Martin5009/delay-pedal/README

A 16-bit, FPGA-based digital delay pedal implementation.
