Martin5009/delay-pedal/pcb/fabrication/delay_pedal-bom-smd.xlsx

Comment | Designator | Footprint | JLCPCB Part # | MFR Part #
X7R_0.1u_Ceramic_Capacitor | C1, C2, C3, C10, C12, C22, C23, C37, C41, C42, C43, C44, C45, C46, C47, C48, C49, C50, C52, C53, C54, C55 | 0603 | C108079 | CC0603KRX7R7BB104
C0G_9.1n_Ceramic_Capacitor | C13, C33 | 0603 | C7282234 | GRM1885C1H912JA01D
C0G_15n_Ceramic_Capacitor | C14, C34 | 0603 | C1882912 | C0603C153M3GEC7411
X7R_10n_Ceramic_Capacitor | C21 | 0603 | C161232 | GCM188R72A103KA37D
X5R_10u_Ceramic_Capacitor | C28, C29, C30, C31, C39 | 0603 | C90053 | GRM188R61A106ME69D
X5R_47u_Ceramic_Capacitor | C35, C56 | 1206 | C94034 | GRM31CR61A476ME15L
X5R_1u_Ceramic_Capacitor | C4, C11, C18, C20, C24, C27, C32, C36, C38, C51 | 0603 | C14664 | CC0603KRX5R8BB105
C0G_0.1u_Ceramic_Capacitor | C5, C60, C40 | 1206 | C363929 | GRM3195C1H104JA05D
C0G_0.47u_Ceramic_Capacitor | C58, C59 | 1206 | C6049896 | GRM31C5C1E474JE01L
C0G_160p_Ceramic_Capacitor | C6, C16 | 0603 | C327274 | CC0603JRNPO9BN161
C0G_8.2n_Ceramic_Capacitor | C7, C17 | 0603 | C162249 | GRM1885C1H822JA01D
C0G_2n_Ceramic_Capacitor | C8, C25 | 0603 | C2168932 | GRM1885C1H202JA01D
C0G_10n_Ceramic_Capacitor | C9, C15, C26 | 0603 | C85973 | GRM1885C1H103JA01D
Clipper_LED_Red | D1, D2 | 0603 | C2693608 | SML-D12U1WT86
Indicator_LED_Green_ | D3, D4 | 0603 | C9900037471 | B1911PG--20D000514U1930
Schottky_Diode | D6 | SOD-323 | C146335 | CUS10S30,H3F
1M_Resistor | R1, R2, R36, R34 | 0603 | C105578 | RC0603FR-071ML
845_Resistor | R10, R27 | 0603 | C273800 | RC0603FR-07845RL
1.82k_Resistor | R11, R28 | 0603 | C273756 | RC0603FR-071K82L
20k_Resistor | R12, R13, R14, R31, R32 | 0603 | C105575 | RC0603FR-0720KL
3.6k_Resistor | R18 | 0603 | C137729 | RC0603FR-073K6L
40k_Resistor | R21, R29, R30, R35 | 0603 | C861392 | RT0603BRD0740KL
10k_Resistor | R3, R8, R15, R16, R17, R19, R20, R33 | 0603 | C98220 | RC0603FR-0710KL
1k_Resistor | R37 | 0603 | C22548 | RC0603FR-071KL
5.23k_Resistor | R4, R23 | 0603 | C185317 | RC0603FR-075K23L
9.76k_Resistor | R5, R24 | 0603 | C137665 | RC0603FR-079K76L
1.47k_Resistor | R6, R25 | 0603 | C482634 | RC0603FR-071K47L
3.32k_Resistor | R7, R26 | 0603 | C137731 | RC0603FR-073K32L
100_Resistor | R9, R22 | 0603 | C2074203 | RCA0603100RFKEAHP
FPGA | U1 | 84-VFQFN_7x7mm | C6639984 | ICE40LP1K-QN84
1.2V_Voltage_Regulator | U10 | SOT-23-5 | C5155199 | TPL810ADJ-5TR
5V_Voltage_Regulator | U11 | SOT-89-3 | C2842393 | TPL810F50-89TR
16_bit_ADC | U12 | VSSOP-10_3x3mm_P0.5mm | C2669921 | ADS8339IDGSR
3.3V_Voltage_Regulator | U13 | SOT-23-3 | C2683368 | TLV76033DBZR
16_bit_DAC | U15 | VSSOP-8_3x3mm_P0.65mm | C524800 | DAC8551IADGKR
4.5V_Reference | U16 | SOIC-8_3.9x4.9mm_P1.27mm | C181339 | REF5045AIDR
SPI_PSRAM | U2 | SOP-8_3.9x4.9mm_P1.27mm | C18214056 | APS1604M-3SQR-SN
Op-amp | U3, U5, U8, U9, U14, U17 | SOIC-8_3.9x4.9mm_P1.27mm | C80100 | RC4580IDR
Level_Translator | U4 | TSSOP-14_4.4x5mm_P0.65mm | C551620 | NXB0104PW-Q100J
SPI_Flash | U6 | SOIC-8_3.9x4.9mm_P1.27mm | C19617 | W25X40CLSNIG
80MHz_Crystal_Oscillator | X1 | 4-VDFN_3.2x2.5mm |  | 12.95102
