Martin5009/delay-pedal/pcb/delay_pedal.pdf

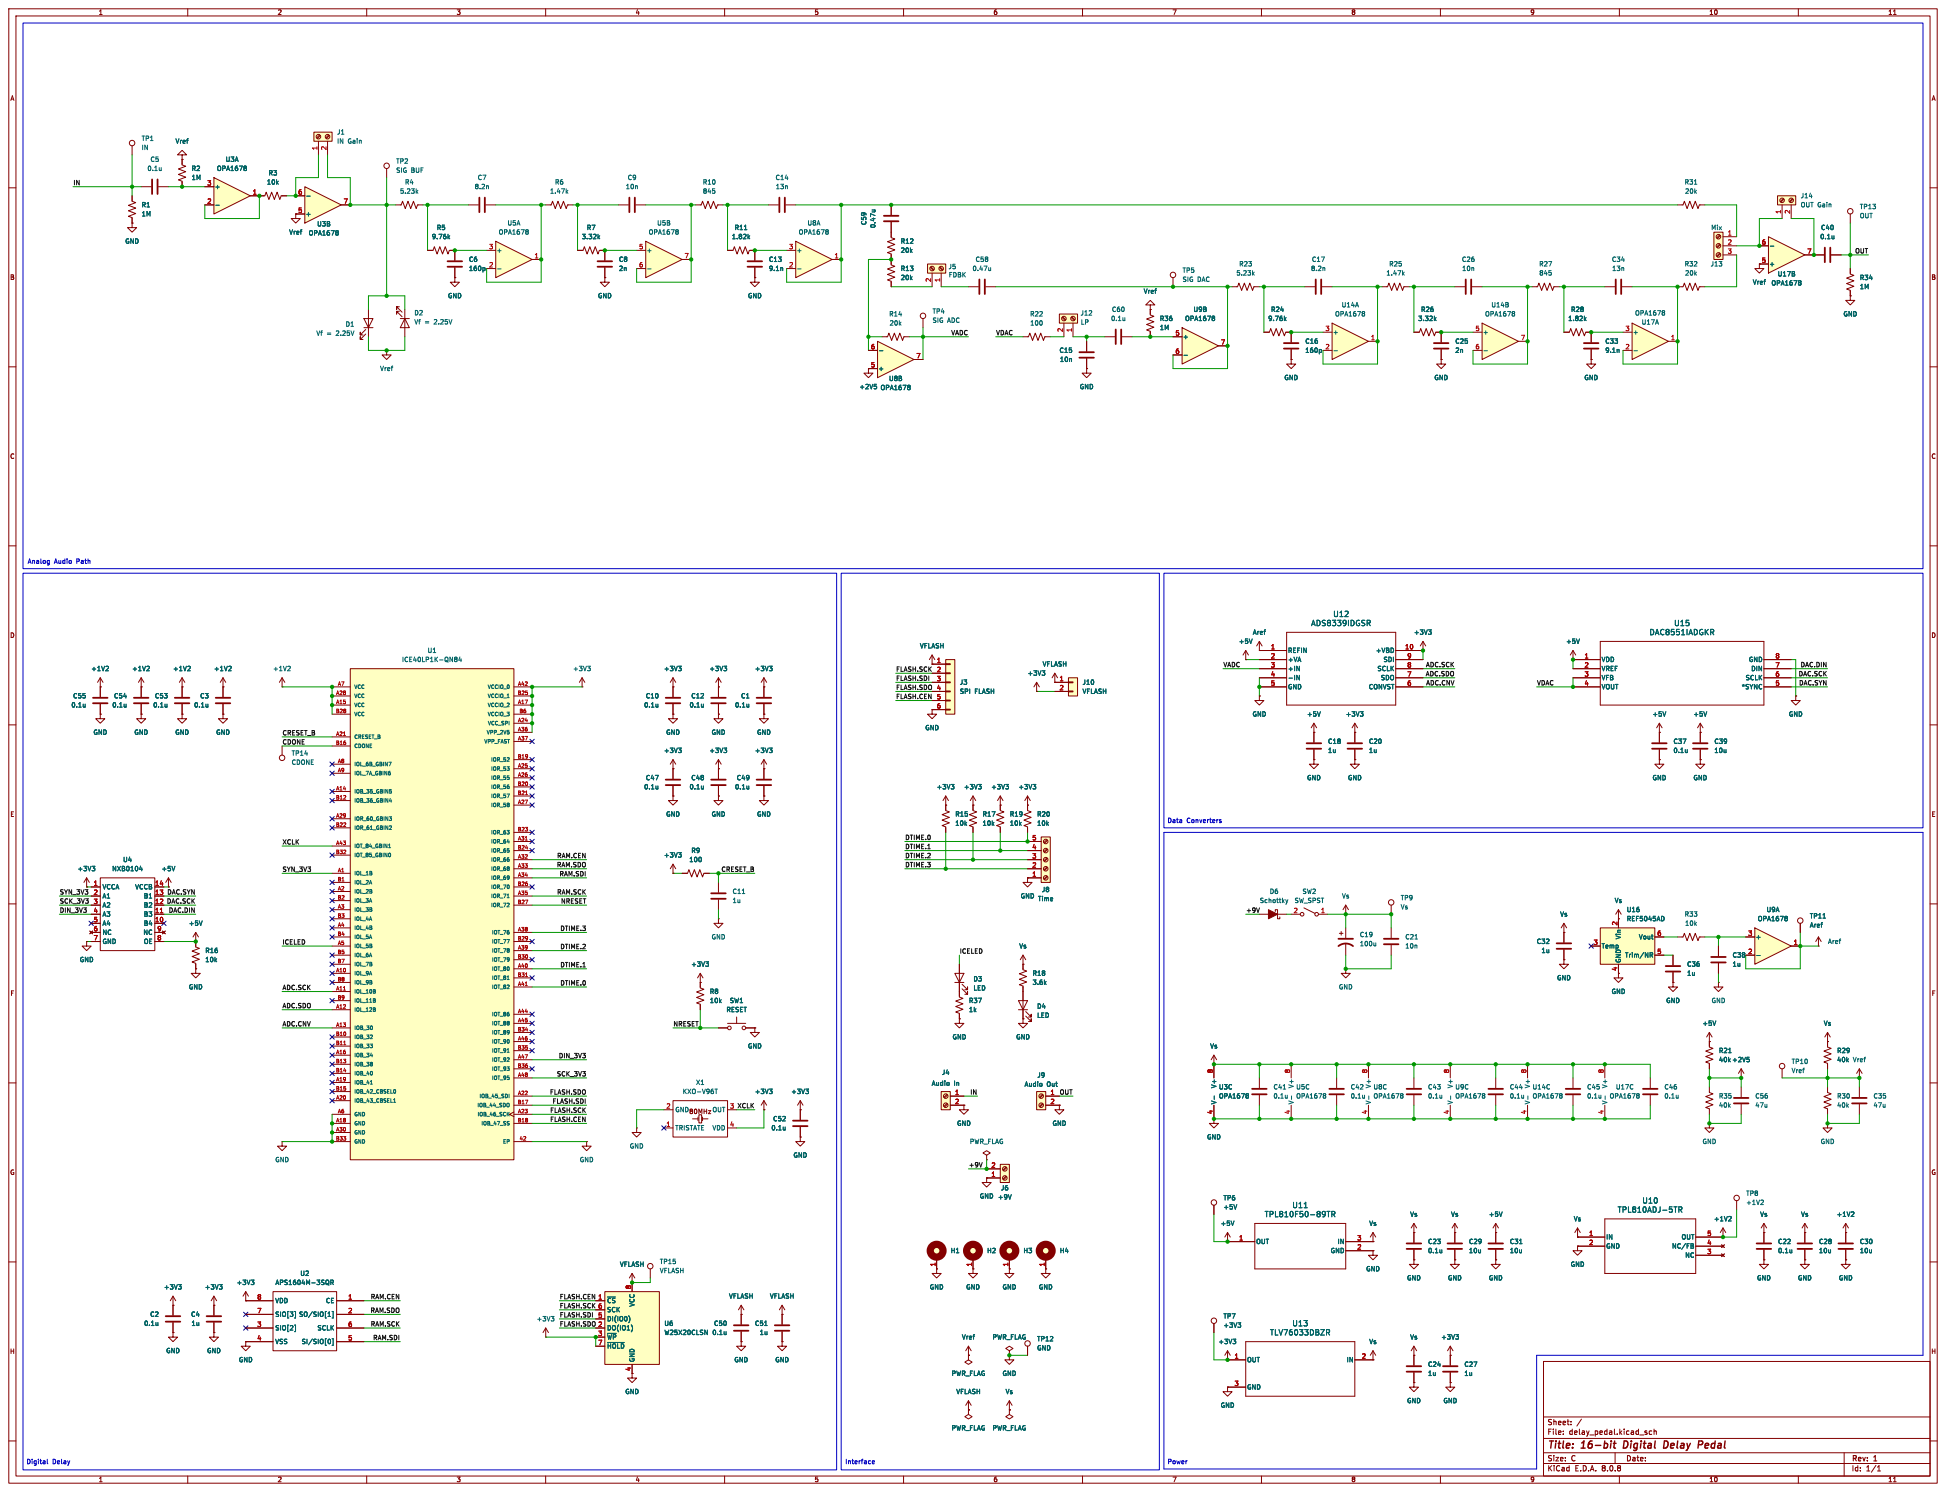
[picture p1: page 1]

FLASH.SCK
DTIME.3 FLASH.SDI FLASH.CEN
FLASH.SDO

FLASH.SDI FLASH.CEN

FLASH.CEN
FLASH.SDI FLASH.SDO

4 DI(IO0) 5 SCK 6 ~{HOLD} 7 VCC
