Martin5009/delay-pedal/pcb/delay_pedal.kicad_pcb

## KiCad design pcb/delay_pedal.kicad_pcb (2025-01-30)

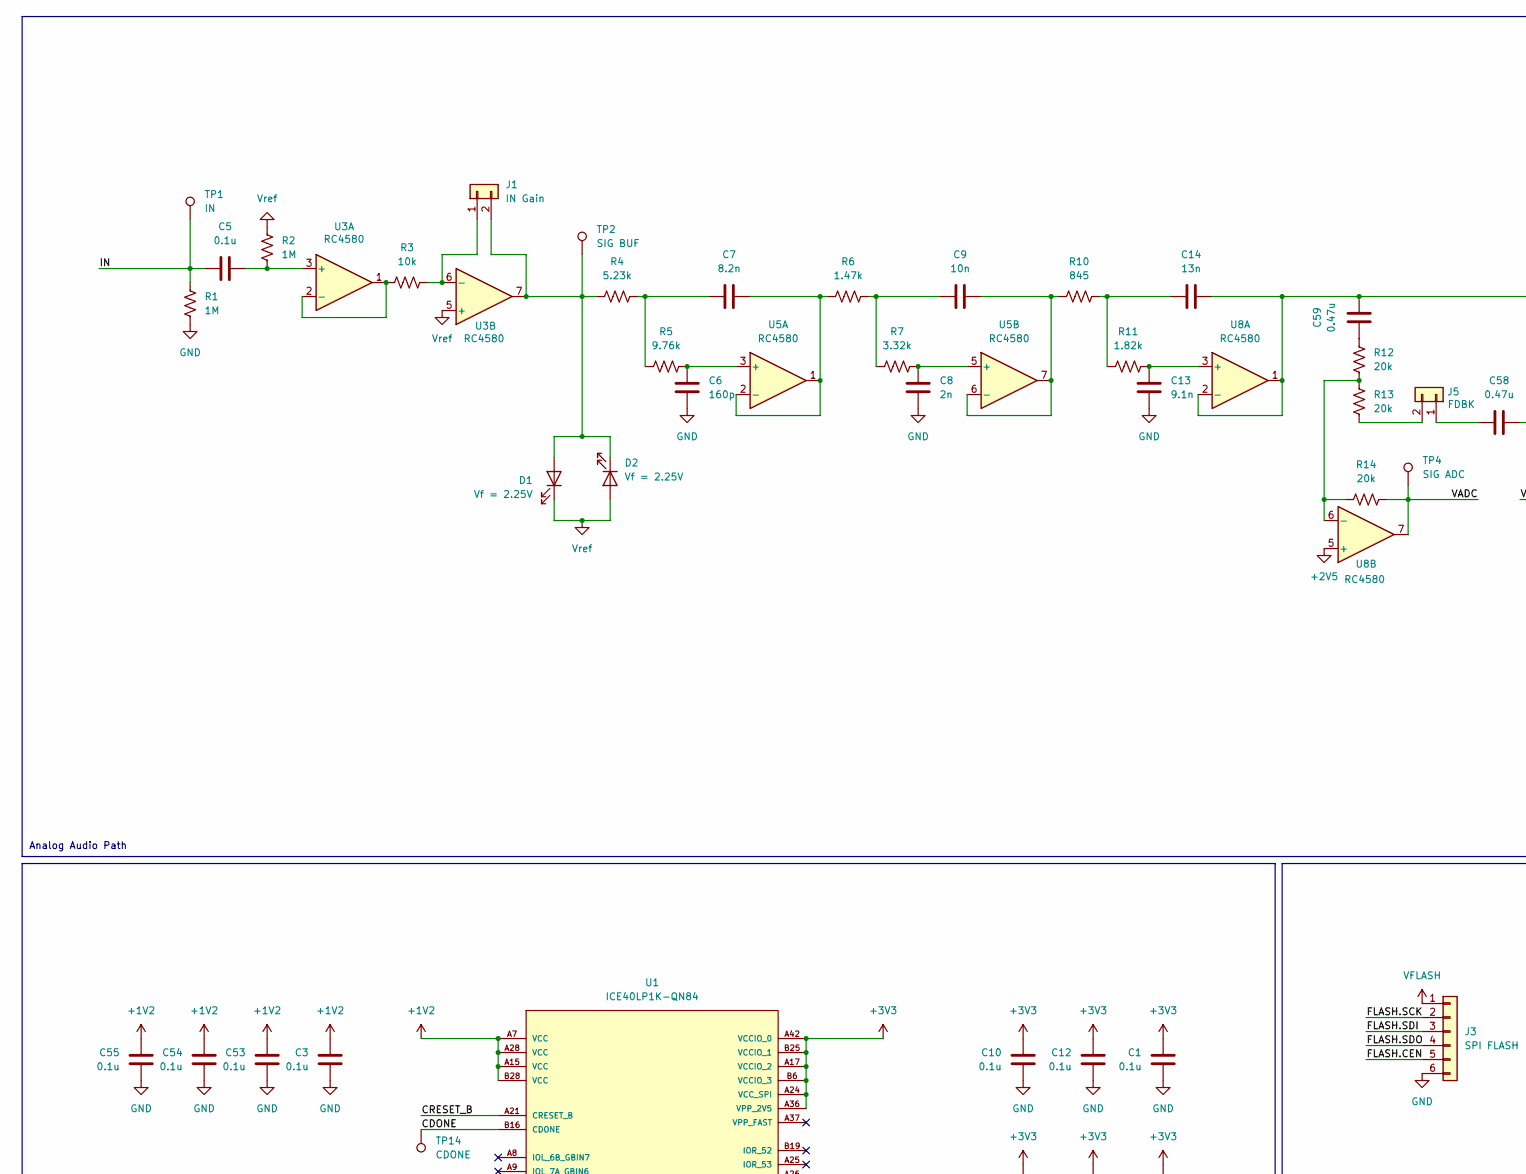
[picture p2: schematic delay_pedal.kicad_sch, 16-bit Digital Delay Pedal, part in row 1, column 1]

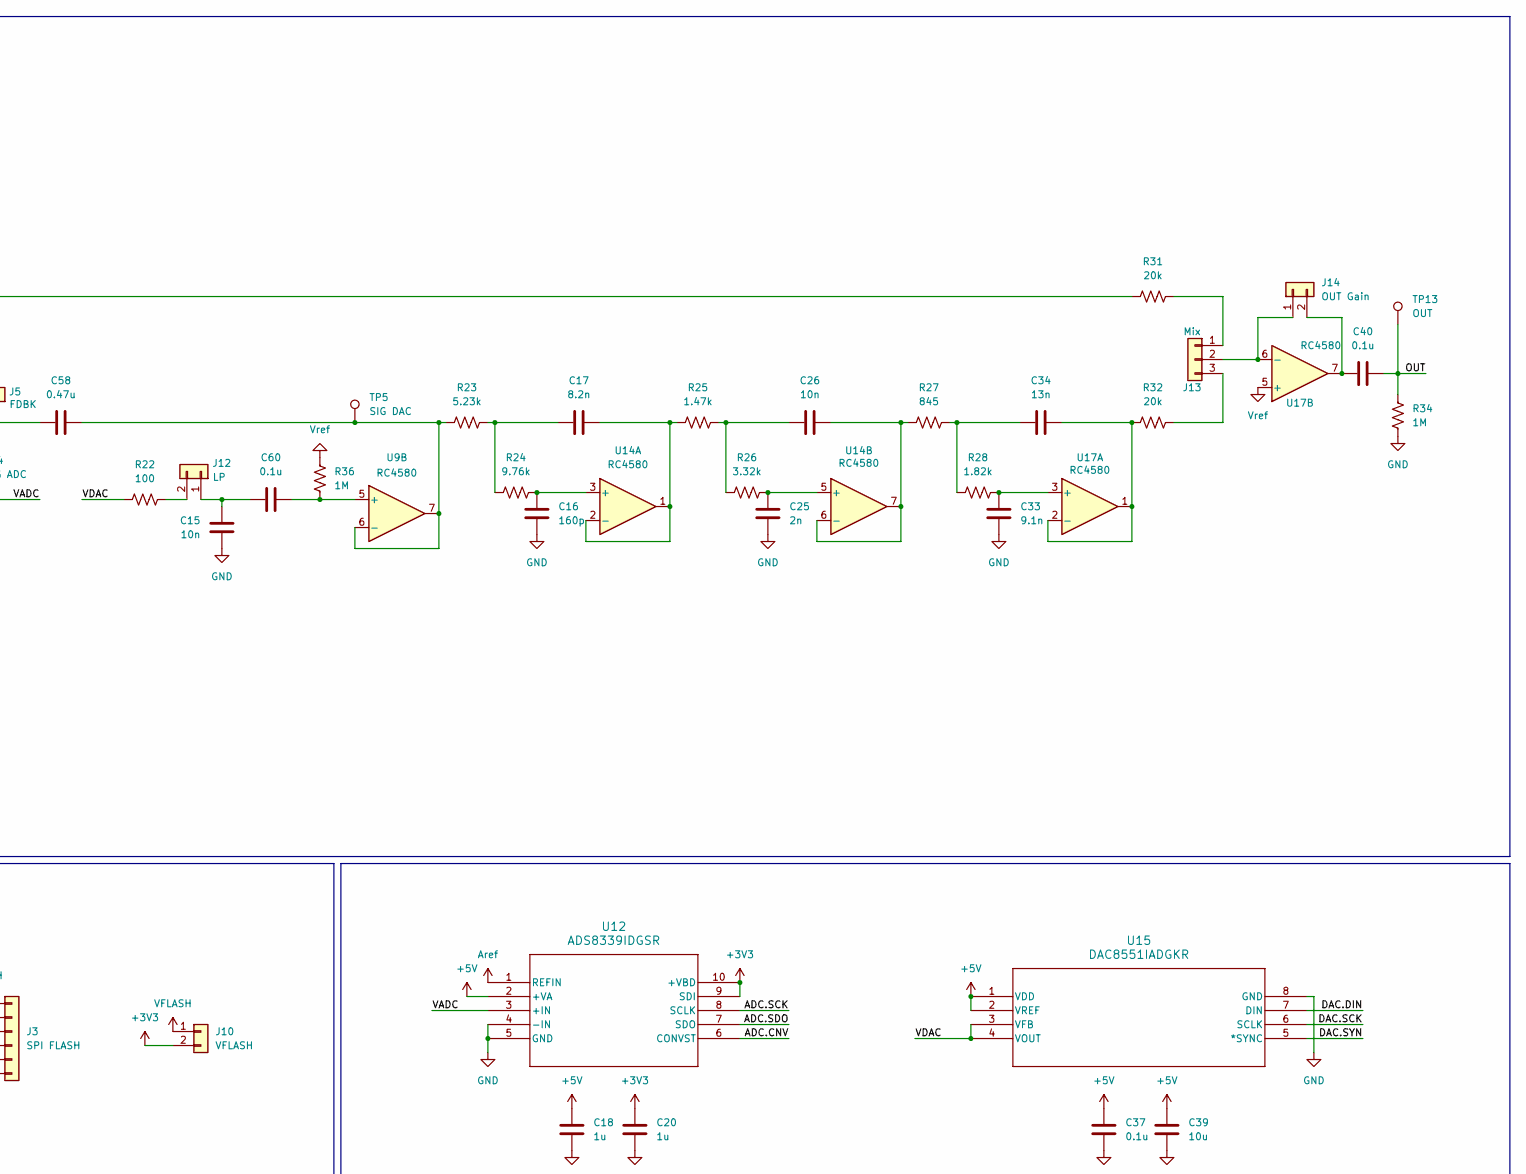
[picture p3: schematic delay_pedal.kicad_sch, 16-bit Digital Delay Pedal, part in row 1, column 2]

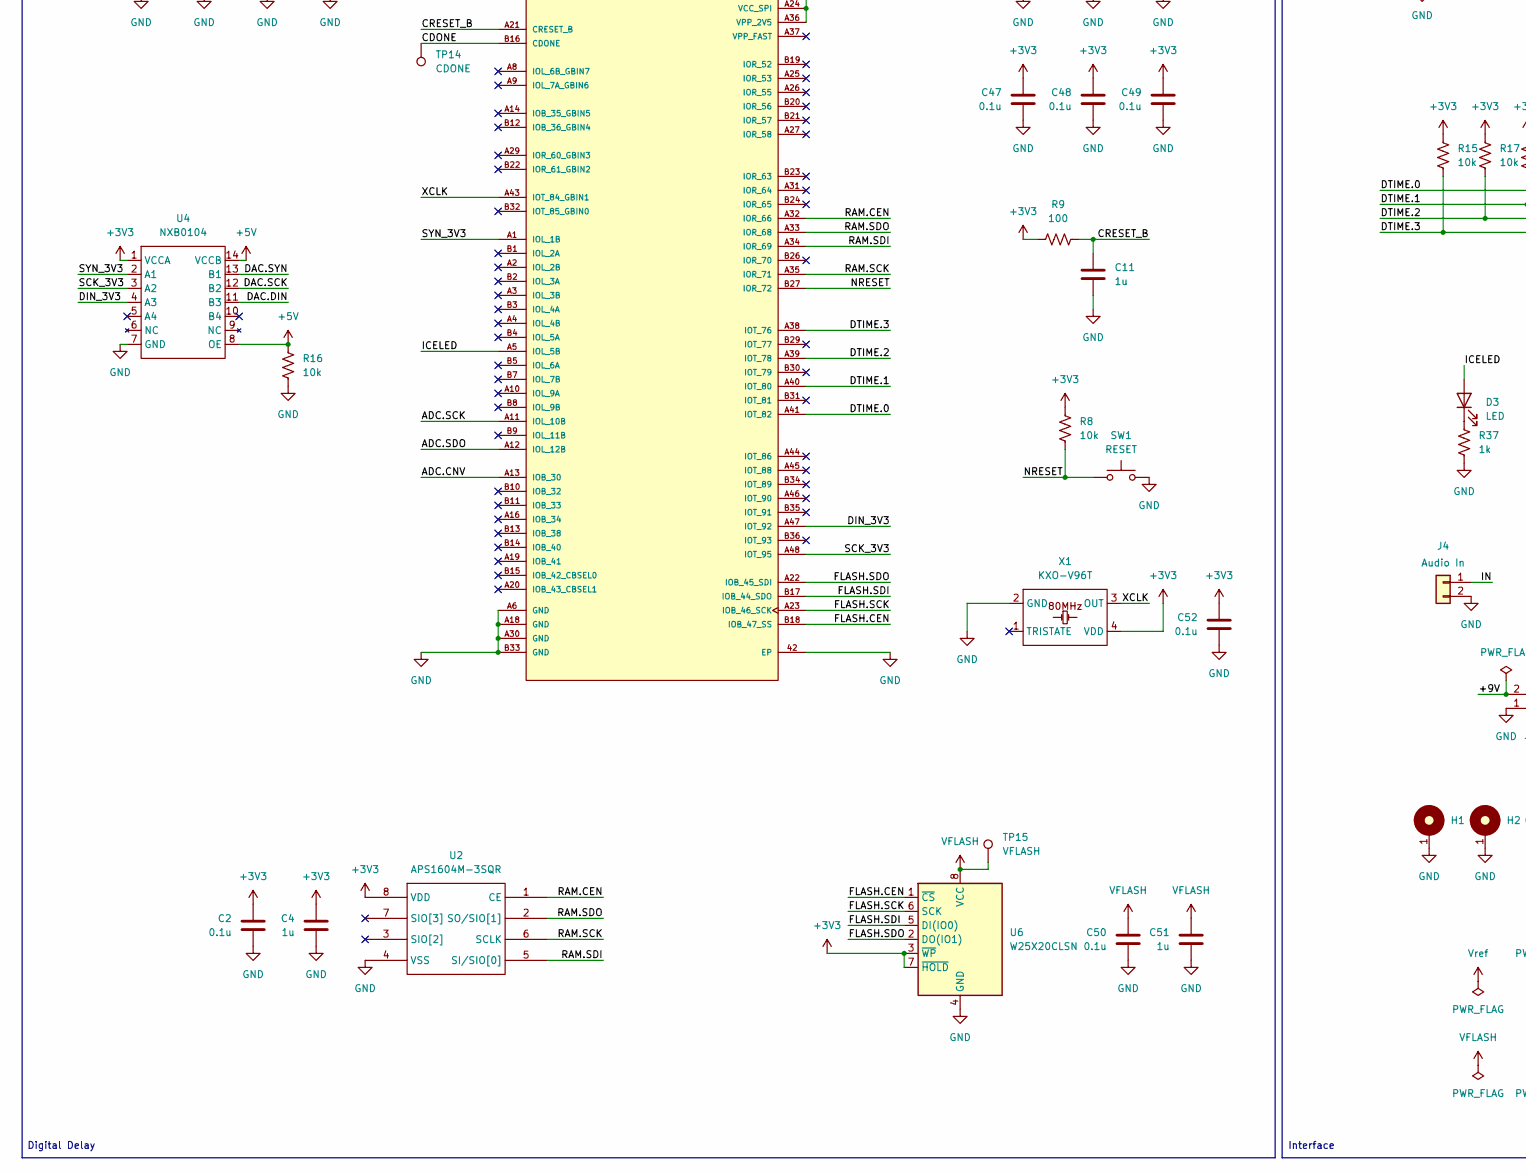
[picture p4: schematic delay_pedal.kicad_sch, 16-bit Digital Delay Pedal, part in row 2, column 1]

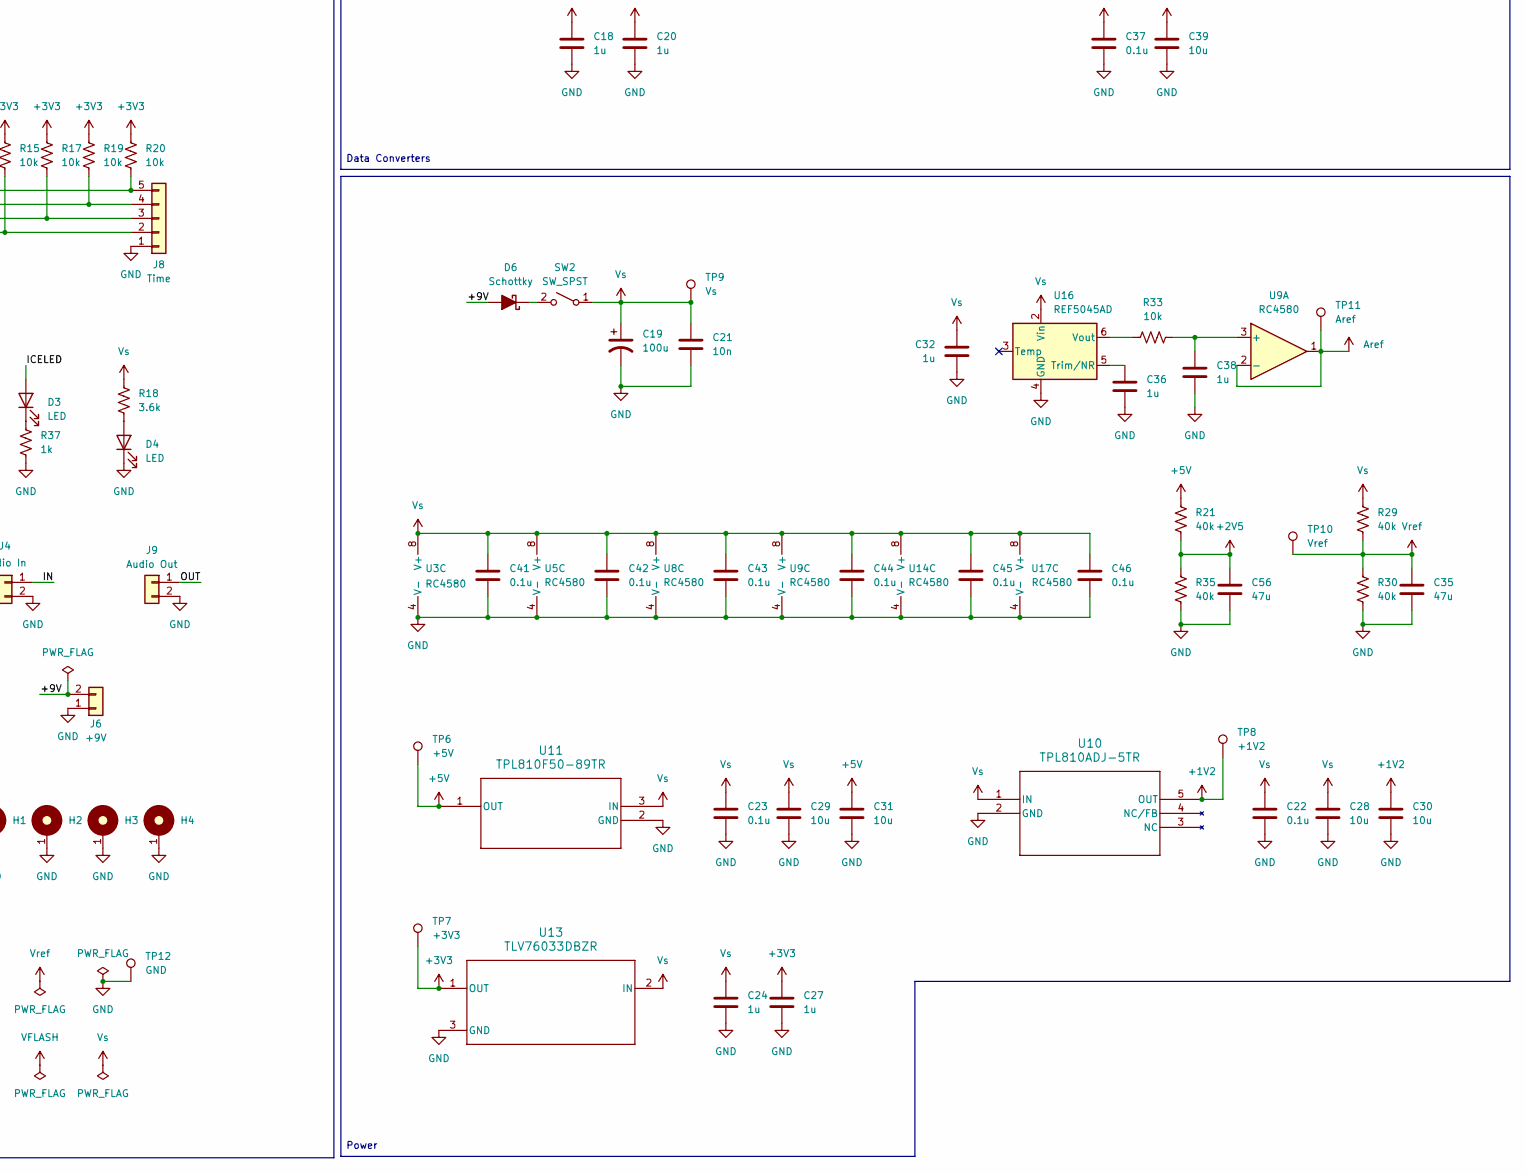
[picture p5: schematic delay_pedal.kicad_sch, 16-bit Digital Delay Pedal, part in row 2, column 2]

Parts:
C1, C2, C3, C10, C12, C22, C23, C37, C41, C42, C43, C44, C45, C46, C47, C48, C49, C50, C52, C53, C54, C55: 0.1u; C_0603_1608Metric_Pad1.08x0.95mm_HandSolder
C4, C11, C18, C20, C24, C27, C32, C36, C38, C51: 1u; C_0603_1608Metric_Pad1.08x0.95mm_HandSolder
C5, C40, C60: 0.1u; C_1206_3216Metric_Pad1.33x1.80mm_HandSolder
C6, C16: 160p; C_0603_1608Metric_Pad1.08x0.95mm_HandSolder
C7, C17: 8.2n; C_0603_1608Metric_Pad1.08x0.95mm_HandSolder
C8, C25: 2n; C_0603_1608Metric_Pad1.08x0.95mm_HandSolder
C9, C15, C21, C26: 10n; C_0603_1608Metric_Pad1.08x0.95mm_HandSolder
C13, C33: 9.1n; C_0603_1608Metric_Pad1.08x0.95mm_HandSolder
C14, C34: 13n; C_0603_1608Metric_Pad1.08x0.95mm_HandSolder
C19: 100u; CP_Radial_D6.3mm_P2.50mm
C28, C29, C30, C31, C39: 10u; C_0603_1608Metric_Pad1.08x0.95mm_HandSolder
C35, C56: 47u; C_1206_3216Metric_Pad1.33x1.80mm_HandSolder
C58, C59: 0.47u; C_1206_3216Metric_Pad1.33x1.80mm_HandSolder
D1, D2: Vf = 2.25V; LED_0603_1608Metric_Pad1.05x0.95mm_HandSolder
D3, D4: LED; LED_0603_1608Metric_Pad1.05x0.95mm_HandSolder
D6: Schottky; D_SOD-323_HandSoldering
H1, H2, H3, H4: MountingHole_M3_3.2mm_Pad; MountingHole_3.2mm_Pad
J1: IN Gain; PinHeader_1x02_P2.54mm_Vertical
J3: SPI FLASH; PinHeader_1x06_P2.54mm_Vertical
J4: Audio In; PinHeader_1x02_P2.54mm_Vertical
J5: FDBK; PinHeader_1x02_P2.54mm_Vertical
J6: +9V; PinHeader_1x02_P2.54mm_Vertical
J8: Time; PinHeader_1x05_P2.54mm_Vertical
J9: Audio Out; PinHeader_1x02_P2.54mm_Vertical
J10: VFLASH; PinHeader_1x02_P2.54mm_Vertical
J12: LP; PinHeader_1x02_P2.54mm_Vertical
J13: Mix; PinHeader_1x03_P2.54mm_Vertical
J14: OUT Gain; PinHeader_1x02_P2.54mm_Vertical
R1, R2, R34, R36: 1M; R_0603_1608Metric_Pad0.98x0.95mm_HandSolder
R3, R8, R15, R16, R17, R19, R20, R33: 10k; R_0603_1608Metric_Pad0.98x0.95mm_HandSolder
R4, R23: 5.23k; R_0603_1608Metric_Pad0.98x0.95mm_HandSolder
R5, R24: 9.76k; R_0603_1608Metric_Pad0.98x0.95mm_HandSolder
R6, R25: 1.47k; R_0603_1608Metric_Pad0.98x0.95mm_HandSolder
R7, R26: 3.32k; R_0603_1608Metric_Pad0.98x0.95mm_HandSolder
R9, R22: 100; R_0603_1608Metric_Pad0.98x0.95mm_HandSolder
R10, R27: 845; R_0603_1608Metric_Pad0.98x0.95mm_HandSolder
R11, R28: 1.82k; R_0603_1608Metric_Pad0.98x0.95mm_HandSolder
R12, R13, R14, R31, R32: 20k; R_0603_1608Metric_Pad0.98x0.95mm_HandSolder
R18: 3.6k; R_0603_1608Metric_Pad0.98x0.95mm_HandSolder
R21, R29, R30, R35: 40k; R_0603_1608Metric_Pad0.98x0.95mm_HandSolder
R37: 1k; R_0603_1608Metric_Pad0.98x0.95mm_HandSolder
SW1: RESET; SW_PUSH_1P1T_6x3.5mm_H4.3_APEM_MJTP1243
SW2: SW_SPST; PinHeader_1x02_P2.54mm_Vertical
TP1: IN; TestPoint_THTPad_D1.0mm_Drill0.5mm
TP2: SIG BUF; TestPoint_THTPad_D1.0mm_Drill0.5mm
TP4: SIG ADC; TestPoint_THTPad_D1.0mm_Drill0.5mm
TP5: SIG DAC; TestPoint_THTPad_D1.0mm_Drill0.5mm
TP6: +5V; TestPoint_THTPad_D1.0mm_Drill0.5mm
TP7: +3V3; TestPoint_THTPad_D1.0mm_Drill0.5mm
TP8: +1V2; TestPoint_THTPad_D1.0mm_Drill0.5mm
TP9: Vs; TestPoint_THTPad_D1.0mm_Drill0.5mm
TP10: Vref; TestPoint_THTPad_D1.0mm_Drill0.5mm
TP11: Aref; TestPoint_THTPad_D1.0mm_Drill0.5mm
TP12: GND; TestPoint_THTPad_D1.0mm_Drill0.5mm
TP13: OUT; TestPoint_THTPad_D1.0mm_Drill0.5mm
TP14: CDONE; TestPoint_THTPad_D1.0mm_Drill0.5mm
TP15: VFLASH; TestPoint_THTPad_D1.0mm_Drill0.5mm
U1: ICE40LP1K-QN84; LATTICE_ICE40LP1K-QN84; PARTREV 3.4; DigiKey_Part_Number 220-1561-ND
U2: APS1604M-3SQR; SOP-8_3.9x4.9mm_P1.27mm
U3, U5, U8, U9, U14, U17: RC4580; SOIC-8_3.9x4.9mm_P1.27mm
U4: NXB0104; TSSOP-14_4.4x5mm_P0.65mm
U6: W25X20CLSN; SOIC-8_3.9x4.9mm_P1.27mm
U10: TPL810ADJ-5TR; SOT-23-5_HandSoldering
U11: TPL810F50-89TR; SOT-89-3_Handsoldering
U12: ADS8339IDGSR; VSSOP-10_3x3mm_P0.5mm
U13: TLV76033DBZR; SOT-23-3
U15: DAC8551IADGKR; VSSOP-8_3x3mm_P0.65mm
U16: REF5045AD; SOIC-8_3.9x4.9mm_P1.27mm
X1: KXO-V96T; Oscillator_SMD_Abracon_ASE-4Pin_3.2x2.5mm

Connections:
+1V2: C3.1, C30.1, C53.1, C54.1, C55.1, TP8.1, U1.A7 (VCC), U1.A15 (VCC), U1.A28 (VCC), U1.B28 (VCC), U10.5 (OUT)
+2V5: C56.1, R21.2, R35.1, U8.5 (+)
+3V3: C1.1, C2.1, C4.1, C10.1, C12.1, C20.1, C27.1, C47.1, C48.1, C49.1, C52.1, J10.2, R8.1, R9.2, R15.1, R17.1, R19.1, R20.1, TP7.1, U1.A17 (VCCIO_2), U1.A24 (VCC_SPI), U1.A36 (VPP_2V5), U1.A42 (VCCIO_0), U1.B6 (VCCIO_3), U1.B25 (VCCIO_1), U2.8 (VDD), U4.1 (VCCA), U6.3 (~WP), U6.7 (~HOLD), U12.9 (SDI), U12.10 (+VBD), U13.1 (OUT), X1.4 (VDD)
+5V: C18.1, C31.1, C37.1, C39.1, R16.1, R21.1, TP6.1, U4.8 (OE), U4.14 (VCCB), U11.1 (OUT), U12.2 (+VA), U15.1 (VDD), U15.2 (VREF)
/+9V: D6.2 (A), J6.2
/ADC.CNV: U1.A13 (IOB_30), U12.6 (CONVST)
/ADC.SCK: U1.A11 (IOL_10B), U12.8 (SCLK)
/ADC.SDO: U1.A12 (IOL_12B), U12.7 (SDO)
/CDONE: TP14.1, U1.B16 (CDONE)
/CRESET_B: C11.1, R9.1, U1.A21 (CRESET_B)
/DAC.DIN: U4.11 (B3), U15.7 (DIN)
/DAC.SCK: U4.12 (B2), U15.6 (SCLK)
/DAC.SYN: U4.13 (B1), U15.5 (*SYNC)
/DIN_3V3: U1.A47 (IOT_92), U4.4 (A3)
/DTIME.0: J8.5, R20.2, U1.A41 (IOT_82)
/DTIME.1: J8.4, R19.2, U1.A40 (IOT_80)
/DTIME.2: J8.3, R17.2, U1.A39 (IOT_78)
/DTIME.3: J8.2, R15.2, U1.A38 (IOT_76)
/FLASH.CEN: J3.5, U1.B18 (IOB_47_SS), U6.1 (~CS)
/FLASH.SCK: J3.2, U1.A23 (IOB_46_SCK), U6.6 (SCK)
/FLASH.SDI: J3.3, U1.B17 (IOB_44_SDO), U6.5 (DI(IO0))
/FLASH.SDO: J3.4, U1.A22 (IOB_45_SDI), U6.2 (DO(IO1))
/ICELED: D3.2 (A), U1.A5 (IOL_5B)
/IN: C5.1, J4.1, R1.1, TP1.1
/NRESET: R8.2, SW1.1, U1.B27 (IOR_72)
/OUT: C40.2, J9.1, R34.1, TP13.1
/RAM.CEN: U1.A32 (IOR_66), U2.1 (CE)
/RAM.SCK: U1.A35 (IOR_71), U2.6 (SCLK)
/RAM.SDI: U1.A34 (IOR_69), U2.5 (SI/SIO[0])
/RAM.SDO: U1.A33 (IOR_68), U2.2 (SO/SIO[1])
/SCK_3V3: U1.A48 (IOT_95), U4.3 (A2)
/SYN_3V3: U1.A1 (IOL_1B), U4.2 (A1)
/VADC: R14.1, TP4.1, U8.7, U12.3 (+IN)
/VDAC: R22.2, U15.3 (VFB), U15.4 (VOUT)
/XCLK: U1.A43 (IOT_84_GBIN1), X1.3 (OUT)
Aref: TP11.1, U9.1, U9.2 (-), U12.1 (REFIN)
GND: C1.2, C2.2, C3.2, C4.2, C6.2, C8.2, C10.2, C11.2, C12.2, C13.2, C15.2, C16.2, C18.2, C19.2, C20.2, C21.2, C22.2, C23.2, C24.2, C25.2, C27.2, C28.2, C29.2, C30.2, C31.2, C32.2, C33.2, C35.2, C36.2, C37.2, C38.2, C39.2, C41.2, C42.2, C43.2, C44.2, C45.2, C46.2, C47.2, C48.2, C49.2, C50.2, C51.2, C52.2, C53.2, C54.2, C55.2, C56.2, D4.1 (K), H1.1, H2.1, H3.1, H4.1, J3.6, J4.2, J6.1, J8.1, J9.2, R1.2, R16.2, R30.2, R34.2, R35.2, R37.2, SW1.2, TP12.1, U1.42 (EP), U1.A6 (GND), U1.A18 (GND), U1.A30 (GND), U1.B33 (GND), U2.4 (VSS), U3.4 (V-), U4.7 (GND), U5.4 (V-), U6.4 (GND), U8.4 (V-), U9.4 (V-), U10.2 (GND), U11.2 (GND), U12.4 (-IN), U12.5 (GND), U13.3 (GND), U14.4 (V-), U15.8 (GND), U16.4 (GND), U17.4 (V-), X1.2 (GND)
unnamed: C7.1, R4.1, R5.2
unnamed: C9.1, R6.1, R7.2
unnamed: C14.1, R10.1, R11.2
unnamed: C17.1, R23.1, R24.2
unnamed: C26.1, R25.1, R26.2
unnamed: C34.1, R27.1, R28.2
unnamed: C59.1, R12.1
unnamed: D1.2 (A), D2.1 (K), J1.2, R4.2, TP2.1, U3.7
unnamed: D3.1 (K), R37.1
unnamed: D4.2 (A), R18.2
unnamed: D6.1 (K), SW2.2 (B)
unnamed: J1.1, R3.1, U3.6 (-)
unnamed: C58.1, J5.1
unnamed: J5.2, R13.2
unnamed: C15.1, C60.1, J12.1
unnamed: J12.2, R22.1
unnamed: J13.1, R31.1
unnamed: J13.2, J14.1, U17.6 (-)
unnamed: J13.3, R32.1
unnamed: C40.1, J14.2, U17.7
unnamed: C5.2, R2.2, U3.3 (+)
unnamed: R3.2, U3.1, U3.2 (-)
unnamed: C6.1, R5.1, U5.3 (+)
unnamed: C7.2, R6.2, U5.1, U5.2 (-)
unnamed: C8.1, R7.1, U5.5 (+)
unnamed: C9.2, R10.2, U5.6 (-), U5.7
unnamed: C13.1, R11.1, U8.3 (+)
unnamed: C14.2, C59.2, R31.2, U8.1, U8.2 (-)
unnamed: R12.2, R13.1, R14.2, U8.6 (-)
unnamed: C38.1, R33.1, U9.3 (+)
unnamed: C60.2, R36.2, U9.5 (+)
unnamed: C58.2, R23.2, TP5.1, U9.6 (-), U9.7
unnamed: C16.1, R24.1, U14.3 (+)
unnamed: C17.2, R25.2, U14.1, U14.2 (-)
unnamed: C25.1, R26.1, U14.5 (+)
unnamed: C26.2, R27.2, U14.6 (-), U14.7
unnamed: C36.1, U16.5 (Trim/NR)
unnamed: R33.2, U16.6 (Vout)
unnamed: C33.1, R28.1, U17.3 (+)
unnamed: C34.2, R32.2, U17.1, U17.2 (-)
VFLASH: C50.1, C51.1, J3.1, J10.1, TP15.1, U6.8 (VCC)
Vref: C35.1, D1.1 (K), D2.2 (A), R2.1, R29.2, R30.1, R36.1, TP10.1, U3.5 (+), U17.5 (+)
Vs: C19.1, C21.1, C22.1, C23.1, C24.1, C28.1, C29.1, C32.1, C41.1, C42.1, C43.1, C44.1, C45.1, C46.1, R18.1, R29.1, SW2.1 (A), TP9.1, U3.8 (V+), U5.8 (V+), U8.8 (V+), U9.8 (V+), U10.1 (IN), U11.3 (IN), U13.2 (IN), U14.8 (V+), U16.2 (Vin), U17.8 (V+)

Notes on the sheet:
Data Converters
Power
Analog Audio Path
Digital Delay
Interface

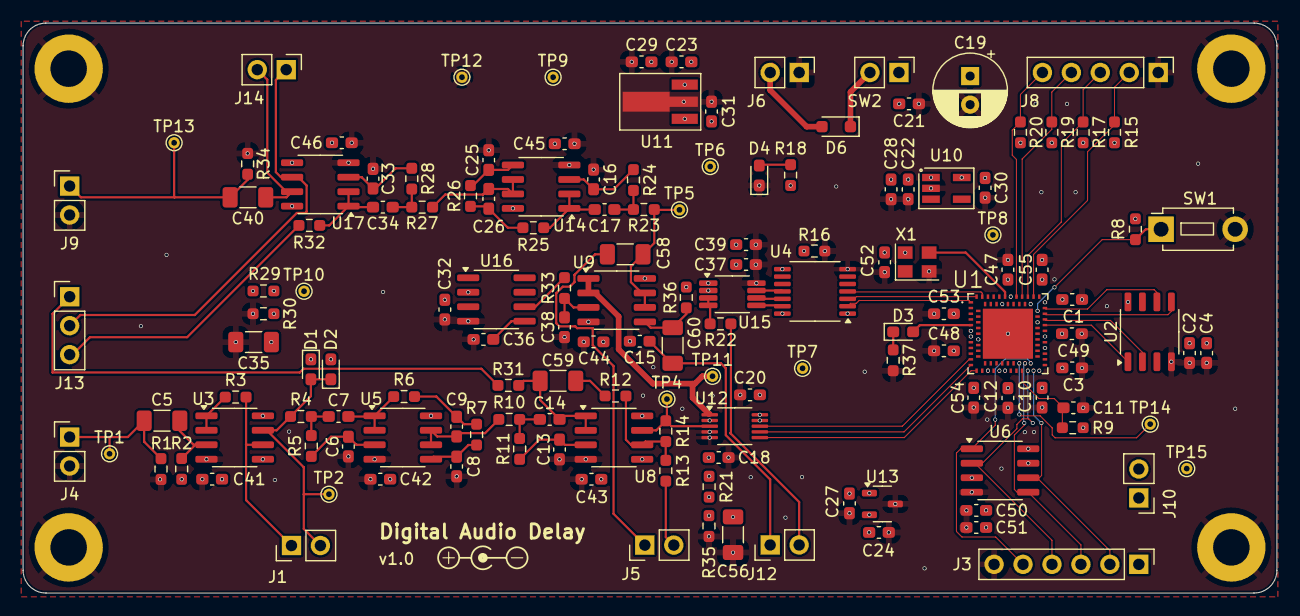
[picture p6: board delay_pedal.kicad_pcb from above]

Board: 4 copper layers, 110.0 x 50.0 mm, 149 parts (0 on the bottom side), 80 nets.
