Martin5009/delay-pedal/(commit log)

2025-01-10 delay_core no longer requires external clock pulse to start conversion
    [delay_core.sv, delay_core_tb.sv]
2025-01-16 Created fast_spi_controller, a module that supports SPI transactions at the system clock rate
2025-01-17 Added circuit schematic folder
2025-01-17 Updated pin assignments
2025-01-22 Fixed source of synthesis errors
    [fast_spi_controller.sv, spi_controller.sv]
2025-01-23 Added KiCAD files
    [delay_pedal.kicad_pcb, delay_pedal.kicad_sch]
2025-01-23 Updated schematic PDF
2025-01-23 Added missing capacitors to analog signal chain
    [delay_pedal.kicad_pcb, delay_pedal.kicad_sch]
2025-01-23 End of day
    [delay_pedal.kicad_pcb]
2025-01-23 Updated Schottky diode footprint
    [delay_pedal.kicad_pcb, delay_pedal.kicad_sch]
2025-01-24 Generated fabrication files
    [delay_pedal-B_Cu.gbl, delay_pedal-B_Mask.gbs, delay_pedal-B_Paste.gbp, delay_pedal-B_Silkscreen.gbo, delay_pedal-Edge_Cuts.gm1, delay_pedal-F_Cu.gtl, delay_pedal-F_Mask.gts, delay_pedal-F_Paste.gtp]
2025-01-24 Fixed footprint assignments
    [delay_pedal-B_Cu.gbl, delay_pedal-B_Mask.gbs, delay_pedal-B_Paste.gbp, delay_pedal-B_Silkscreen.gbo, delay_pedal-Edge_Cuts.gm1, delay_pedal-F_Cu.gtl, delay_pedal-F_Mask.gts, delay_pedal-F_Paste.gtp]
2025-01-24 Generated new gerbers
2025-01-25 Moved power supply LED close to power supply input
    [delay_pedal.kicad_pcb]
2025-01-30 Added silkscreen art
    [delay_pedal.kicad_pcb]
2025-01-31 Generated new fabrication files
    [delay_pedal-B_Cu.gbl, delay_pedal-B_Mask.gbs, delay_pedal-B_Paste.gbp, delay_pedal-B_Silkscreen.gbo, delay_pedal-Edge_Cuts.gm1, delay_pedal-F_Cu.gtl, delay_pedal-F_Mask.gts, delay_pedal-F_Paste.gtp]
